ft71th/uav-underwater-system/(commit log)

2026-02-22 Initial commit: UAV underwater tethered system
    - Boj Arduino: PWM reader (Skyfly RX), GPS (MAX3232), RS485 sender
    - UAV Arduino: RS485 receiver, PCA9685 servo/ESC driver, failsafe
    - README with wiring, libraries, and troubleshooting
    [boj_arduino.ino, uav_arduino.ino]
2026-03-19 Add wiring diagram v3: RS485 GPS, MAX3232 removed
    - GPS upgraded to E108 GN04G-485 (RS485)
    - MAX3232 module removed
    - Added MAX485 #2 in buoy for GPS (permanent RX mode)
    - Complete pin-by-pin wiring for all modules
    - Component list updated (now 3x MAX485)
2026-03-19 Add wiring diagram v3 as PDF
2026-03-23 Wiring diagram v4: WAGO PLC gateway architecture
    - WAGO PFC200 as central gateway between buoy and UAV Arduino
    - 750-652 #1: Buoy RS485 link (underwater cable)
    - 750-652 #2: UAV Arduino RS485 link (internal)
    - 750-466: Pressure sensor 4-20mA (depth)
    - 750-530: Digital out -> relay -> linear actuator (ballast)
    - 750-626: Power distribution module
    - DVL (Ethernet) and IMU/AHRS placeholders
    - Ballast now controlled by WAGO DO, PCA9685 CH4 freed
    - Dual 22.2V batteries: top=WAGO+buoy, bottom=motor
    - Complete component list and power flow diagram
2026-03-23 Add print-friendly PDF (white background)
2026-03-23 Fix print PDF: darker colors for architecture diagram
